adimunot21/TCTD-Pump/Electronics.md

The system is run using a microcontroller (Arduino UNO) connected to a stepper motor via a driver (A4988). A bubble sensor and buzzer are connected to the board as well.

The motor driver allows to easily control the steppper motor. it requires a 12V supply from a battery Connect a 47 uF capacitor between the two battery pins:

<b>12V --> VMOT

<b>GND --> GND</b>

Connect the 12V battery to Vin on arduino as well to power it.
<b>12V --> Vin</b>

The 4 wires from the stepper motor go into 1A 1B 2A 2B according to thei coil configurations. To figure out the pairs, use try and error.

<b>Coil 1 --> 1A

Coil 1 --> 1B

Coil 2 --> 2A

Coil 2 --> 2B</b>

The driver also connects to the power pins in the arduino.

<b>5V --> VDD

GND --> GND</b>

A stepper motor is instructed in two ways, how many steps to take and in what direction. Thus 2 pins are connected to digital pins in the arduino, STEP and DIR

<b>Digital Pin 8 --> STEP

Digital Pin 9 --> DIR</b>

The sleep and reset pins on the driver are connected to each other

<b>SLEEP --> RESET</b>

To reduce the vibrations and increase the accuracy, A4988 allows a 1/16th microstepping, thus a 200 step rotation becomes a 3200 step rotation. This allows more precise measurements.

<b>5V --> MS1

5V --> MS2

5V --> MS3</b>

A bubble sensor is used to detect air gaps. It has 3 pins, a 5V, GND and an Output pin. (Their are 2 output pins, but only one is needed for detection)

<b>5V --> 5V on arduino

GND --> GND on arduino

OUTPUT --> Digital pin 3 </b>

Connect a load resistor of 1k between the 5V and output pins of the sensor.

Laslty, a buzzer is connected to act as an alarm.

<b>+VE --> Digital pin 13

-VE --> GND on arduino</b>
