adimunot21/TCTD-Pump/Infusion Pump CAD (Printed) v1.step

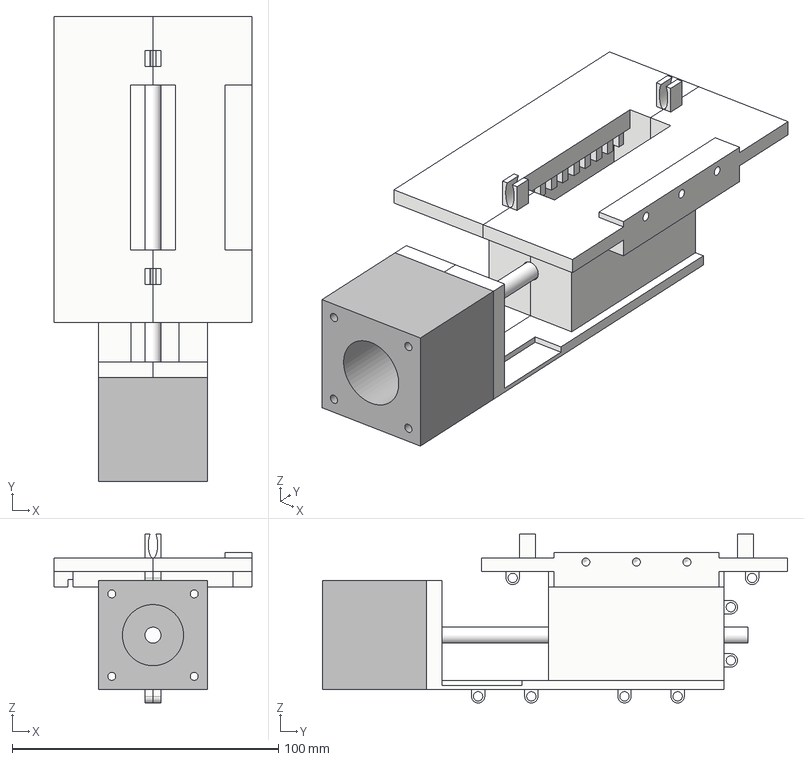
[picture p1: CAD file, 2022-09-12]
Infusion Pump CAD (Printed) v1.step
74.4 x 174.8 x 63.5 mm
Left Half
Right Half
Motor
Shaft
