adimunot21/TCTD-Pump/Cam Follower DXF.dxf

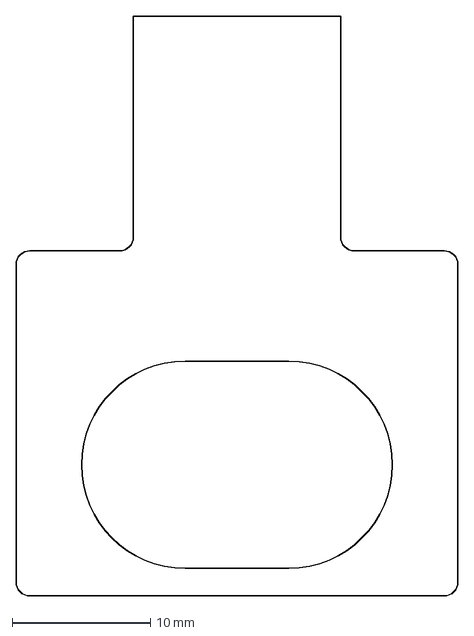
[picture p2: CAD file, 2022-09-12]
Cam Follower DXF.dxf
32.0 x 42.0 mm
