adimunot21/TCTD-Pump/Cam Circle DXF.dxf

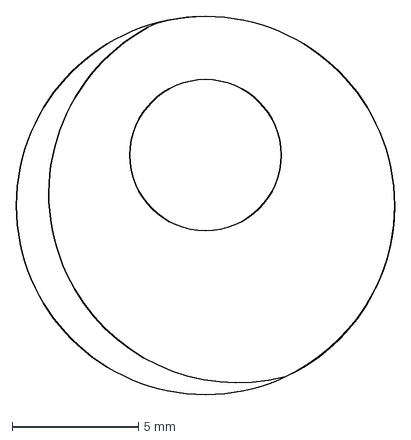
[picture p3: CAD file, 2022-09-12]
Cam Circle DXF.dxf
15.0 x 15.2 mm
