adimunot21/TCTD-Pump/(list of files, cad)

Other CAD files:
Infusion Pump CAD (Printed).f3d
Infusion Pump Suggested Changes.f3d
